kambria-platform/tb-light-hardware/README.md

# tb-light-hardware	 
Eagle board design and BOM for LED strip controller.
