kambria-platform/tb-light-hardware/boards/tb-light-001.brd

## EAGLE design boards/tb-light-001.brd (2018-03-13)

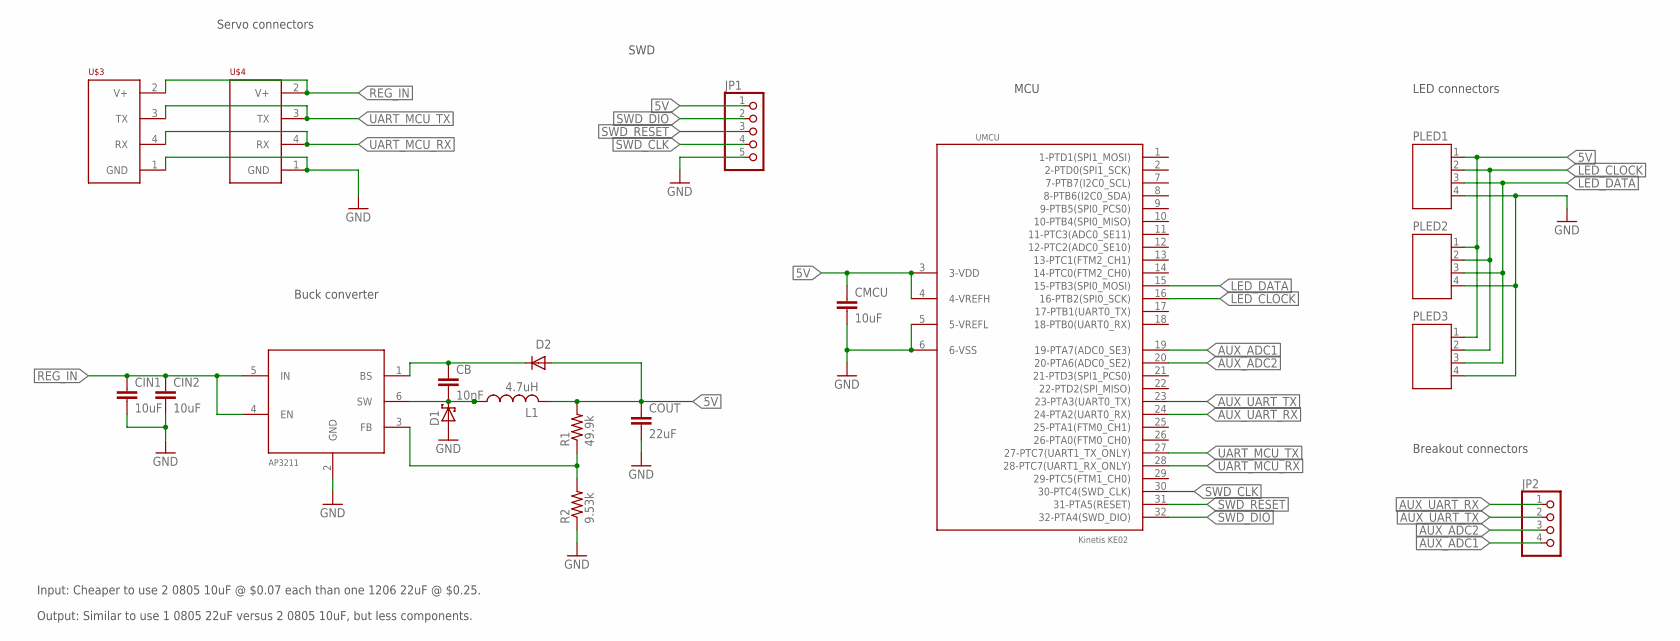
[picture p1: schematic tb-light-001.sch]

Parts:
CB: 10nF; C0805; DIGIKEY# 1276-1015-1-ND
CIN1, CIN2: 10uF; C0805; DIGIKEY# 490-5523-1-ND
CMCU: 10uF; C0805; DIGIKEY# 490-5523-1-ND
COUT: 22uF; C0805; DIGIKEY# 490-10511-1-ND
D1: SCHOTTKY; SOD-123FL; DIGIKEY# DB2X41500LCT-ND
D2: SMALL-SIGNALSOD-123; SOD-123; DIGIKEY# 1N4148W-FDICT-ND
JP1: PINHD-1X5; 1X05; DIGIKEY# MANUAL_PLACE
JP2: PINHD-1X4; 1X04; DIGIKEY# DNP
L1: 4.7uH; L_NR6028; DIGIKEY# 587-2100-1-ND
PLED1, PLED2, PLED3: JST-PH4; DIGIKEY# 455-1706-ND
R1: 49.9k; R0805; DIGIKEY# 311-49.9KCRCT-ND
R2: 9.53k; R0805; DIGIKEY# 311-9.53KCRCT-ND
U$3, U$4: SERVO-CONNVERT; TE-AMP-4PIN; DIGIKEY# A98779-ND
UMCU: KE02; TQFP32-08; DIGIKEY# MKE02Z32VLC4-ND
UREG: AP3211; SOT23-6; DIGIKEY# AP3211KTR-G1DICT-ND

Connections:
5V: CMCU.1, COUT.1, D2.A, JP1.1, L1.P$2 (2), PLED1.1, PLED2.1, PLED3.1, R1.2, UMCU.3 (3-VDD), UMCU.4 (4-VREFH)
AUX_ADC1: JP2.4, UMCU.19 (19-PTA7(ADC0_SE3))
AUX_ADC2: JP2.3, UMCU.20 (20-PTA6(ADC0_SE2))
AUX_UART_RX: JP2.1, UMCU.24 (24-PTA2(UART0_RX))
AUX_UART_TX: JP2.2, UMCU.23 (23-PTA3(UART0_TX))
GND: CIN1.2, CIN2.2, CMCU.2, COUT.2, D1.A, JP1.5, PLED1.4, PLED2.4, PLED3.4, R2.1, U$3.1 (GND), U$4.1 (GND), UMCU.5 (5-VREFL), UMCU.6 (6-VSS), UREG.2 (GND)
LED_CLOCK: PLED1.2, PLED2.2, PLED3.2, UMCU.16 (16-PTB2(SPI0_SCK))
LED_DATA: PLED1.3, PLED2.3, PLED3.3, UMCU.15 (15-PTB3(SPI0_MOSI))
unnamed: R1.1, R2.2, UREG.3 (FB)
unnamed: CB.2, D1.C, L1.P$1 (1), UREG.6 (SW)
unnamed: CB.1, D2.C, UREG.1 (BS)
REG_IN: CIN1.1, CIN2.1, U$3.2 (V+), U$4.2 (V+), UREG.4 (EN), UREG.5 (IN)
SWD_CLK: JP1.4, UMCU.30 (30-PTC4(SWD_CLK))
SWD_DIO: JP1.2, UMCU.32 (32-PTA4(SWD_DIO))
SWD_RESET: JP1.3, UMCU.31 (31-PTA5(RESET))
UART_MCU_RX: U$3.4 (RX), U$4.4 (RX), UMCU.28 (28-PTC7(UART1_RX_ONLY))
UART_MCU_TX: U$3.3 (TX), U$4.3 (TX), UMCU.27 (27-PTC7(UART1_TX_ONLY))

Notes on the sheet:
Input: Cheaper to use 2 0805 10uF @ $0.07 each than one 1206 22uF @ $0.25.
Output: Similar to use 1 0805 22uF versus 2 0805 10uF, but less components.
Servo connectors
Buck converter
MCU
LED connectors
Breakout connectors
SWD

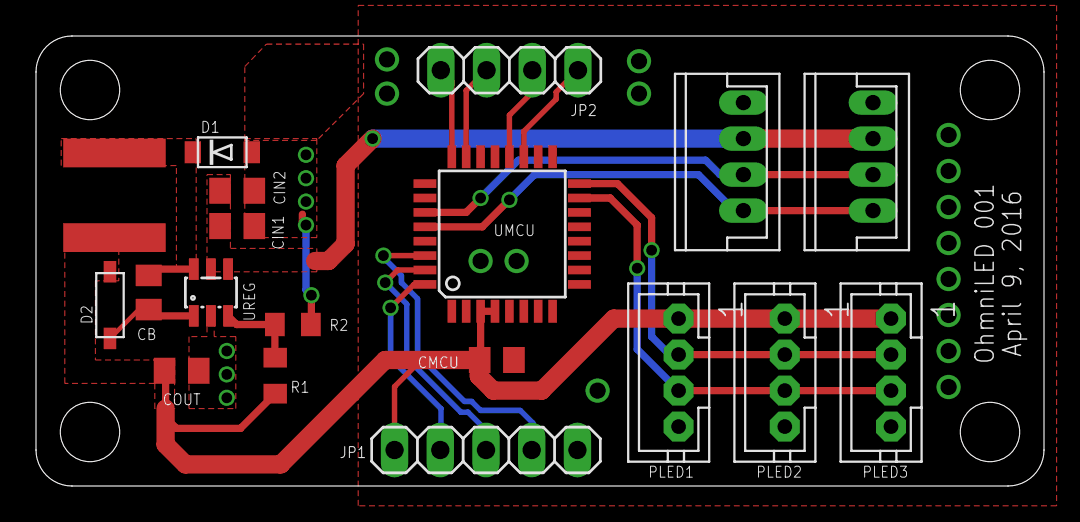
[picture p2: board tb-light-001.brd from above]

Board: 2 copper layers, 56.0 x 25.0 mm, 20 parts (1 on the bottom side), 17 nets.

Other parts of the board:
U$1: LOGO-HORIZ-SMALL
