kambria-platform/tb-light-hardware/(commit log)

2018-03-14 move files
    [tb-light-001.brd, tb-light-001.csv, tb-light-001.sch, tb-light.brd, tb-light.sch]
2018-05-08 updated bom with links
    [tb-light-001.csv]
2018-05-08 updated kdna for BOM display fields
    [tb-light-001.csv]
2018-05-08 fixed bom with null links
    [tb-light-001.csv]
